Duocervisia/e-paper-esp32-frame/Schematic for Components.png

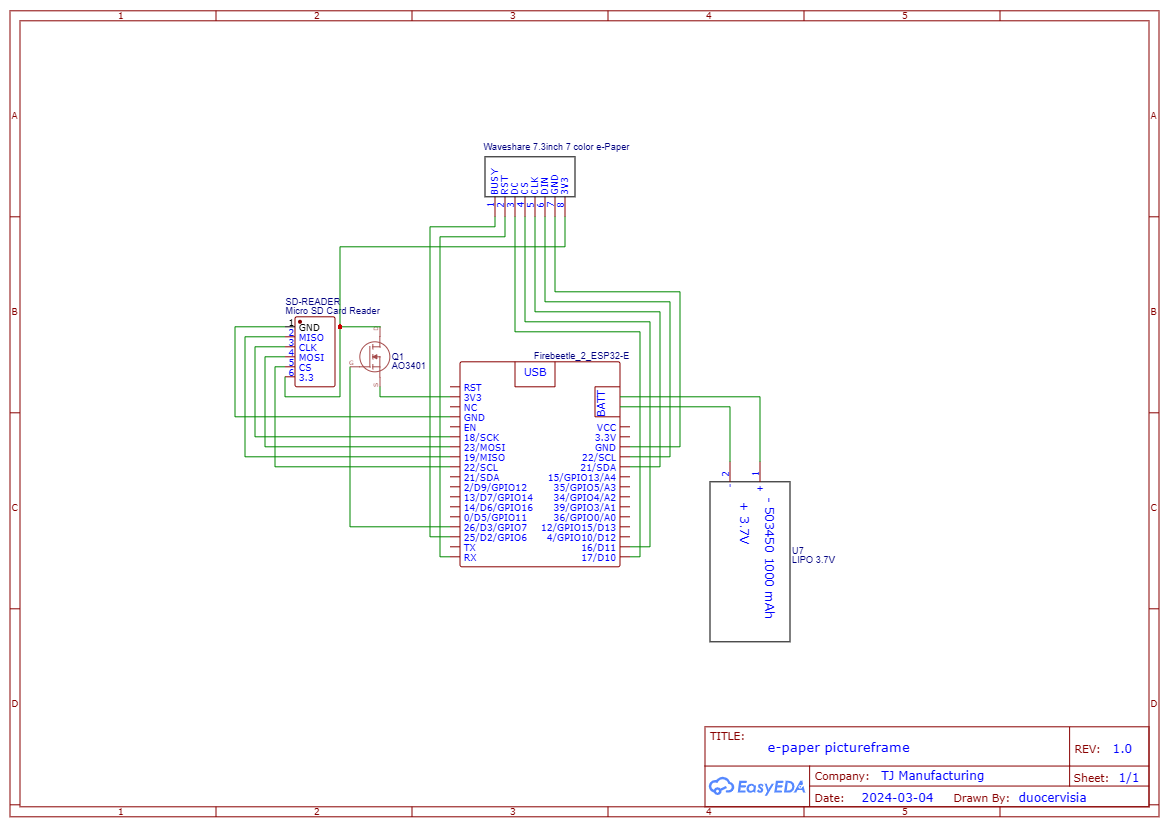
Schematic for Components.png
