Duocervisia/e-paper-esp32-frame/(threads)

Thread 1 (2024-11-26):

Alternative way of knowing time

QC20, 2024-11-26:
Hi all,

After reviewing the setup, I started thinking it might be worth exploring alternative ways to determine the time for this project. It would be great if the project could function without relying on an internet connection, especially in locations where WiFi isn't available.

How could this be achieved? I feel this could be a valuable addition to enhance the project's versatility! 😊

lbendlin, 2025-02-10:
You could add a RTC module to fight the clock drift of the ESP32.  It would still require an internet connection, but much less frequently (twice a year with the DST changes would be enough).  You would need to put SCK and MOSI elsewhere though as that is currently blocking I2C.

Of course you could use a GPS module but that would likely eat up a lot of wattage.

Duocervisia, 2025-03-24:
That could be something to add in the future. We didn't have the time to look for alternatives, but feel free to find better solutions! Closing this for now.

Thread 2 (2025-03-16):

Consider using Spectra 6 display

lbendlin, 2025-03-16:
Not an issue - more of a suggestion.  I started using the 7 color display but was taken aback by the poor color space coverage that made all pictures look like sepia, even after exact color calibration for the palette.  Then I tried the same display but with six colors (the "e" version rather than the "f" version.  What a difference!!!  Much more vibrant and eye pleasing, no more reddish hue on every other refresh.

pink88, 2025-04-13:
I still have the F version, and have the latest main branch code. I've been through and reverted back the changes made to support the Spectre 6 and I think I have everything. However, I'm getting very washed out images.

Using the supplied bmp converted, the image is full screen, but mostly white with a little bit of sepia and you cannot make out any real detail? For example:

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

I can run EPD_7IN3F_Show7Block absolutely fine and it looks good, so I dont think there is an issue with the display. Any idea? Is there a working branch somewhere for the F version of the waveshape display?

lbendlin, 2025-04-13:
Make sure you use the correct color mapping. It is very different for the Spectra 6.

pal =  (0,0,0, 255,255,255,  226,190,40, 167,16,23, 0,0,0, 0,82,156, 51,124,81) #black, white,yellow,red,orange,blue,green (orange not implemented)

pink88, 2025-04-14:
Sorry @lbendlin , not sure what that all means? I tried to use that palette with @Duocervisia code, but its still coming out washed out for me.

Duocervisia, 2025-04-15:
Hello @pink88 ,
Did you try to connect the display directly to the 3v pin? I think this might be a problem with the transistor. Some people pointed out, that another type of transistor fixed some issues with the display:
https://www.reddit.com/r/esp32/s/IFdKMFfMx2

I didn't test it myself, but maybe this is the problem.

lbendlin, 2025-04-15:
I run my setup without the transistor (I mostly use Deep Sleep which allegedly cuts power to all peripherals ? - Have yet to do long term battery tests).  I have seen washed out images when sending a 7 color converted BMP to a 6 color display.  Not surprising because both the order of the colors is different, but also the color space match is very different between the two.

@pink88 happy to assist with the image conversion issue.  As mentioned elsewhere I use an external Python script to convert any JPEG to the appropriately sized, dithered, and encoded BMP.  I also added my own little palette lookup table (first 21 bytes of the BMP data) because I couldn't figure out yet if the default palette function in the BMP header supports 24bit palettes.

pink88, 2025-04-15:
@Duocervisia  that did the trick.  It's working now.

lbendlin, 2025-04-28:
A quick note - the Good-Display version of the ePaper screen  does really only support "6" colors (well, in reality only four),  but the Waveshare version ( SKU 27863 ) actually accepts and displays Orange.  (Again, doesn't make a big difference as it is just a mix of red and yellow, but interesting nevertheless).

Thread 3 (2025-03-16):

Floyd Steinberg on JPEG images

lbendlin, 2025-03-16:
To make the photo frame easier to use it would be nice if it were possible to  use JPEG files instead of BMP for the initial source. Mobile phone pictures and camera pictures are more likely to be in JPEG format.  Not sure if the ESP32 version you are using has enough RAM to even attempt that.  I use a Python script on the SD card  at the moment but I am looking for something more end user friendly.

Duocervisia, 2025-03-24:
We decided to use .bmp files to make it easy for the ESP to read the images. Unfortunately, I don't have the time to do something like this. Feel free to try it!

Thread 4 (2025-03-23):

Error Drawing bitmap file

pink88, 2025-03-23:
Every time this runs, I get the following error over serial monitor. This has been built on the latest version of Arduino IDE 2.3.4, with the latest esp32 libraries.

```
Drawing bitmap file: /095_10.06.2025_APS2263.bmp
E (5210) adc_oneshot: adc_oneshot_get_calibrated_result(254): adc oneshot read fail

assert failed: heap_caps_free heap_caps_base.c:69 (heap != NULL && "free() target pointer is outside heap areas")

Backtrace: 0x400826ad:0x3ffd38d0 0x4008f191:0x3ffd38f0 0x40095376:0x3ffd3910 0x400838b5:0x3ffd3a40 0x400953a9:0x3ffd3a60 0x4017ad01:0x3ffd3a80 0x40177137:0x3ffd3aa0 0x4008fe0a:0x3ffd3ad0

ELF file SHA256: 45bf82496
```

Decoding the traces and they appear to come from the esp libraries, but unsure what that means.

```
CPU is: ESP32

0x400826ad panic_abort /home/runner/work/esp32-arduino-lib-builder/esp32-arduino-lib-builder/esp-idf/components/esp_system/panic.c 463
0x4008f191 esp_system_abort /home/runner/work/esp32-arduino-lib-builder/esp32-arduino-lib-builder/esp-idf/components/esp_system/port/esp_system_chip.c 92
0x40095376 __assert_func /home/runner/work/esp32-arduino-lib-builder/esp32-arduino-lib-builder/esp-idf/components/newlib/assert.c 80
0x400838b5 heap_caps_free /home/runner/work/esp32-arduino-lib-builder/esp32-arduino-lib-builder/esp-idf/components/heap/heap_caps_base.c 69 (discriminator 1)
0x400953a9 free /home/runner/work/esp32-arduino-lib-builder/esp32-arduino-lib-builder/esp-idf/components/newlib/heap.c 39
0x4017ad01 pp_timer_do_process ?? ?
0x40177137 ppTask ?? ?
0x4008fe0a vPortTaskWrapper /home/runner/work/esp32-arduino-lib-builder/esp32-arduino-lib-builder/esp-idf/components/freertos/FreeRTOS-Kernel/portable/xtensa/port.c 139
```

And doing some further debugging the code is erroring in the drawBmp method, once it begins looping through rows and setting values for nextLineBuffer.

pink88, 2025-04-13:
Managed to get around this issue somehow and its "working", but the images are completely washed out. I will close this and instead comment on issue #2 , as I assume it's related to these changes.

Closed 2025-04-13.

Thread 5 (2025-04-13):

OTA from SD card

lbendlin, 2025-04-13:
Not an issue - more a question/suggestion.  I am trying to add a feature where I can place a "firmware.bin"  file on the SD card and then have the app update on the next startup.  Just in case I find a bug and need to fix the picture viewers that are "out in the wild".

The standard Update command fails because there isn't enough RAM.  But I don't need to update all partitions (I think) and I found some code that uses SEEK on the file in the SD card to avoid the memory issue.

So far I haven't figured out what the minimum requirements are  (identify the "other"  program partition, flash it, and switch to it?) or how to run the update in any other way. Any ideas how to tackle this?

lbendlin, 2025-04-13:
Got it working based on an ancient sample code from 2017 ( SD_Update.ino ).  I changed the partition layout to "Minimal SPIFF with OTA" and that seems to have provided enough space for the update.

Closed 2025-04-13.

Thread 6 (2025-08-30):

AO3400 in schematic is wrong

rjacobs1969, 2025-08-30:
I see your intention however how it's executed it won't work the way it's intended.
To switch the 3v3 rail to the sd card and display you should use a p-channel mosfet but the AO3400 is a N-Channel

The way it's connected in your schematic will power the display and sdcard permanently because the current will flow thru the protection diode inside the mosfet; in other words it will never switch off the power to the sd card and display.

You should change the mosfet for a p-channel version, like the AO3401 or AO3407

Connections:

Source connected to VCC
Drain connected to the power input of SD card and display
Gate to the ESP32 IO pin

You also must add a resistor (ej 10k) between source and gate, when the ESP32 is in deep sleep it's io pins are in floating state (hi-Z),  the resistor insures the mosfet stays switched off while the ESP32 is in deep sleep

Duocervisia, 2025-08-30:
Hello, you're absolutely right. I actually used the AO3401, but i labeled in wrong in the schematic and in the readme. Thanks for finding this!

"You also must add a resistor (ej 10k) between source and gate, when the ESP32 is in deep sleep it's io pins are in floating state (hi-Z), the resistor insures the mosfet stays switched off while the ESP32 is in deep sleep"
I don't really get that part. I'm holding the gate pin high during deep-sleep. Isn't that enough?

rjacobs1969, 2025-08-30:
I rechecked and you're right; you don't need a pull up as the pin you used is a RTC-GPIO pin it will hold it's state/voltage in deep sleep

Closed 2025-08-30.

Thread 7 (2025-09-14):

Display stuck after deep sleep

mattcarter11, 2025-09-14:
_I'm replicating the project with the hardware I had and esp-idf, so they are not a 1 to 1 match, but the principles should be the same._

On esp32-s3 reset, the image gets displayed. But after waking up from deep sleep no image is displayed. After adding some logs, I can see it gets stuck waiting for the BUSY signal after sending the data and refresh command.

But the thing is that if I connect the display directly to 3V3, this doesn't happen, so the problem must be related to the High-Side Switching. Any idea?

I'm using a [NDP6030PL](https://www.mouser.com/datasheet/2/308/FairchildSemiconductor_16141416594165-1191912.pdf), which is a P MOSFET.

Simplifying the code, this is what it does:
```
void app_main(void)
{
    gpio_deep_sleep_hold_dis();
    gpio_hold_dis(GPIO_3V3_TRANSISTOR);

    gpio_config_t io_conf = {
        .pin_bit_mask = (1ULL << GPIO_3V3_TRANSISTOR),
        .mode = GPIO_MODE_OUTPUT,
        .pull_down_en = GPIO_PULLDOWN_DISABLE,
        .pull_up_en = GPIO_PULLDOWN_DISABLE,
        .intr_type = GPIO_INTR_DISABLE,
    };
    gpio_config(&io_conf);

    gpio_set_level(GPIO_3V3_TRANSISTOR, 0);
    vTaskDelay(pdMS_TO_TICKS(10));

    display_init();
    ...

    ESP_LOGI(TAG, "Going to deep sleep");
    display_deinit();

    gpio_set_level(GPIO_3V3_TRANSISTOR, 1);
    gpio_hold_en(GPIO_3V3_TRANSISTOR);
    gpio_deep_sleep_hold_en();

    esp_sleep_enable_timer_wakeup(settings.update_frequency_sec * 1000 * 1000);
    esp_deep_sleep_start();
```
