Duocervisia/e-paper-esp32-frame/(commit log)

2024-02-28 fixed jero code fixe
    [e-paper-esp32-frame.ino]
2025-07-29 Switched from PN2222A transistor to AO3400 mosfet to fix voltage drop issues
    [e-paper-esp32-frame.ino]
2025-08-30 Added hold release for Mosfet pin and fixed Mosfet typo in README.md
    [e-paper-esp32-frame.ino]
2025-08-30 Fixed schematic
